ndanyliw/nanoquad/README.md

nanoquad
========

A low cost quadcopter development platform
