ndanyliw/nanoquad/hardware/Quadrocopter BOM.xlsx

Sheet: BOM
Parts for Quadrocopter
Part | Quantity | Cost | Supplier | Category | Description | URL | Link | Total Cost | Total Cost | $33.41
2.4Ghz Wireless nRF24L01+ Transceiver Module | 1 | $3.84 | ebay | Communication | 1X NRF24L01+ 2.4GHz Antenna Wireless Transceiver Module For Microcontroller EP98 | http://www.ebay.com/sch/?_kw=NRF24L01%2B&_clu=2&_fcid=229&_localstpos=&_sc=1&_sop=15&_stpos=&gbr=1 | link | $3.84
Female Headers | 11 | $0.04 | Sparkfun | Communication | 4x2 Pin Female Header | https://www.sparkfun.com/products/115 | link | $0.41
Male Header | 6 | $0.04 | Sparkfun | Communication | 3x2 Pin Male Header for ICSP | https://www.sparkfun.com/products/116 | link | $0.22
2.4Ghz Wireless nRF24L01+ Transceiver Module | 0 | $6.95 | mdfly | Communication | 2.4Ghz Wireless nRF24L01+ Transceiver Module | http://www.mdfly.com/index.php?main_page=product_info&products_id=81 | link | $0.00
2.4GHz Transceiver IC - nRF24L01+ | 0 | $3.50 | Sparkfun | Communication | 2.4GHz Transceiver IC - nRF24L01+ | https://www.sparkfun.com/products/690 | link | $0.00
7 x 16 Coreless DC Motor | 4 | $1.33 | ebay | Drive | 5pcs x Coreless Motor Aeromodelling Motor Helicopter Motor Size: 7x16 | http://www.ebay.com/itm/5pcs-x-Coreless-Motor-Aeromodelling-Motor-Helicopter-Motor-Size-7x16-/160888004987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 | link | $5.32
4 Quad Propellers | 1 | $1.85 | ebay | Drive | Walkera Mini Quadcopter Spare Part QR-Ladybird-Z-01 Main Blades Propellers Set | http://www.ebay.com/itm/Walkera-Mini-Quadcopter-Spare-Part-QR-Ladybird-Z-01-Main-Blades-Propellers-Set-/310559189326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 | link | $1.85
PMGD370XN | 0 | $0.13 | Mouser | Drive | MOSFET N-CH TRENCH DL 30V | http://www.mouser.com/ProductDetail/NXP-Semiconductors/PMGD370XN115/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 | link | $0.00
Diode | 4 | $0.04 | Mouser | Drive | BAS16-V-GS18 | http://www.mouser.com/ProductDetail/Vishay-Semiconductors/BAS16-V-GS18/ | link | $0.16
6x12 Coreless DC Motor | 0 | $2.05 | DHGate | Drive | Wholesale - 6*12 Mini Coreless Motor 7500RPM electrical motor for micro vibration motor rc heli part diy toys | http://www.dhgate.com/6-12-mini-coreless-motor-7500rpm-electrical/p-ff80808139bf03750139bf80a4972d47.html | link | $0.00
Motor + Propeller Pair | 0 | $6.84 | DHGate | Drive | Wholesale - Four-axis Aircraft Motor Coreless Motor 48000rpm Model Aircraft Motor DIY Toy Parts 5 pairs/lot | http://www.dhgate.com/four-axis-aircraft-motor-coreless-motor-48000rpm/p-ff8080813b22dc5c013b5fcff16c3354.html | link | $0.00
Propeller | 0 | $1.25 | Infinite Hobby | Drive | 3 X 2 plastic Push & Pull | http://www.infinity-hobby.com/main/product_info.php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 | link | $0.00
3.7 V LiPo Battery 240 mAh | 1 | $2.99 | completeheli.com | Power | Hyperion G3 1S 3.7v 240mAh 25C LiPo Battery | http://www.completeheli.com/hyperion-g3-1s-3-7v-240mah-25c-lipo-battery.htm | link | $2.99
TPS61201DRCT | 1 | $2.92 | Mouser | Power | 3.3V DC/DC Switching Regulators 0.3V In Vltg Boost | http://www.mouser.com/ProductDetail/Texas-Instruments/TPS61201DRCT/?qs=sGAEpiMZZMtY9G8Xaw%2fcnn4j7h5zvZsV | link | $2.92
SPDT Switch | 1 | $0.95 | Sparkfun | Power | SMD power switch | https://www.sparkfun.com/products/10860 | link | $0.95
MCP73831 | 1 | $0.60 | Mouser | Power | LiPo Battery Management Charge mgnt contr | http://www.mouser.com/ProductDetail/Microchip-Technology/MCP73831T-2ACI-OT/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 | link | $0.60
2.2 uH Inductor | 1 | $0.29 | Mouser | Power | Fixed Inductors INDCTR LW PROFL WND 1007 2.2uH 20% | http://www.mouser.com/ProductDetail/Taiyo-Yuden/BRHL2518T2R2M/ | link | $0.29
3.7 V LiPo Battery 250 mAh | 0 | $3.99 | AllBattery | Power | Tenergy 3.7V 250mAh 25C LIPO Rechargeable Battery (for MCPX helicopter) | http://www.all-battery.com/Tenergy3.7V250mAh25CLIPORechargeableBattery-30194.aspx | link | $0.00
ATMEGA 328P-AU | 1 | $3.05 | Mouser | Processing | AVR 8-bit uC | http://www.mouser.com/ProductDetail/Atmel/ATMEGA328P-AU/ | link | $3.05
PTS525SM10SMTR | 1 | $0.57 | Mouser | Processing | SMT Reset Switch | http://www.mouser.com/ProductDetail/CK-Components/PTS525SM10SMTR-LFS/ | link | $0.57
16 MHz Crystal | 1 | $0.39 | Mouser | Processing | 16 MHz Crystal, 18 pF, SMD | http://www.mouser.com/ProductDetail/CTS-Electronic-Components/ATS16BSM-1/ | link | $0.39
10 uF Capacitor | 2 | $0.16 | Mouser | Processing | 08056D106KAT2A | http://www.mouser.com/ProductDetail/AVX/08056D106KAT2A/ | link | $0.32
0.1 uF Capacitor | 4 | $0.06 | Mouser | Processing | VJ0805Y104MXXAC | http://www.mouser.com/ProductDetail/Vishay-Vitramon/VJ0805Y104MXXAC/ | link | $0.24
10k Resistor | 5 | $0.04 | Mouser | Processing | 652-CRT0805FZ1002ELF | http://www.mouser.com/ProductDetail/Bourns/CRT0805-FZ-1002ELF/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 | link | $0.20
470 Resistor | 2 | $0.09 | Mouser | Processing | ERA-6AED471V | http://www.mouser.com/ProductDetail/Panasonic-Electronic-Components/ERA-6AED471V/ | link | $0.18
18 pF Cap | 2 | $0.06 | Mouser | Processing | Multilayer Ceramic Capacitors MLCC - SMD/SMT 0805 18pF 10volts C0G 2% | http://www.mouser.com/ProductDetail/Vishay-Vitramon/VJ0805A180GXQCW1BC/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 | link | $0.12
1 nF Capacitor | 2 | $0.06 | Mouser | Processing | VJ0805A102KXAPW1BC | http://www.mouser.com/ProductDetail/Vishay-Vitramon/VJ0805A102KXAPW1BC/ | link | $0.12
1 uF Capacitor | 2 | $0.06 | Mouser | Processing | Multilayer Ceramic Capacitors MLCC - SMD/SMT 0805 1uF 10volts X7R 10% | http://www.mouser.com/ProductDetail/Vishay-Vitramon/VJ0805Y105KXQTW1BC/ | link | $0.12
4.7 uF Capacitor | 2 | $0.06 | Mouser | Processing | VJ0805V475MXQTW1BC | http://www.mouser.com/ProductDetail/Vishay-Vitramon/VJ0805V475MXQTW1BC/ | link | $0.12
Red LED | 1 | $0.10 | Mouser | Processing | 598-8210-107F | http://www.mouser.com/ProductDetail/Dialight/598-8210-107F/?qs=sGAEpiMZZMtEjy7lsqBi5TMaylv1X7iuXYL5BhasljI%3d | link | $0.10
Green LED | 1 | $0.10 | Mouser | Processing | 598-8270-107F | http://www.mouser.com/ProductDetail/Dialight/598-8270-107F/?qs=sGAEpiMZZMtEjy7lsqBi5TMaylv1X7iuX8bwcRPi1pw%3d | link | $0.10
220k Resistor | 1 | $0.09 | Mouser | Processing | ERA-6AED224V | http://www.mouser.com/ProductDetail/Panasonic-Electronic-Components/ERA-6AED224V/ | link | $0.09
2k Resistor | 1 | $0.09 | Mouser | Processing | ERA-6AED202V | http://www.mouser.com/ProductDetail/Panasonic-Electronic-Components/ERA-6AED202V/ | link | $0.09
2M Resistor | 1 | $0.05 | Mouser | Processing | CR0805-JW-205ELF | http://www.mouser.com/ProductDetail/Bourns/CR0805-JW-205ELF/ | link | $0.05
22 nF Capacitor | 0 | $0.09 | Mouser | Processing | VJ0805A222JXAAT | http://www.mouser.com/ProductDetail/Vishay-Vitramon/VJ0805A222JXAAT/ | link | $0.00
L3GD20 | 1 | $6.33 | Mouser | Sensing | Gyroscopes MEMS 3-Axis GRYO 16-Bit Data 1.8V | http://www.mouser.com/ProductDetail/STMicroelectronics/L3GD20/?qs=sGAEpiMZZMswmUeu4VmiECN28rly3Qbx | link | $6.33
MMA8652FCR1 | 1 | $1.10 | Mouser | Sensing | Board Mount Accelerometers 3-axis 2g/4g/8g 12 bit | http://www.mouser.com/ProductDetail/Freescale-Semiconductor/MMA8652FCR1/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 | link | $1.10
Accelerometer/Magnometer | 0 | $6.35 | Mouser | Sensing | Board Mount Accelerometers E-compass 3D accel & 3D magnetometer mod. | http://www.mouser.com/ProductDetail/STMicroelectronics/LSM303DLHC/ | link | $0.00
SI1902CDL-T1-GE3 | 2 | $0.28 | Mouser | Drive | MOSFET 20V 1A DUAL NCH | http://www.mouser.com/Search/ProductDetail.aspx | link | $0.56

Sheet: Total Cost
Date | Description | Cost | Total: | $36.02 | Balance: | $238.98
2013-02-23 | Freescale Accellerometer Sample order | $5.00
2013-02-19 | 5x Motors | $8.15
2013-02-19 | 2x NRF Radios | $7.73
2013-03-09 | R2 Boards ordered | $15.14
