ndanyliw/nanoquad/hardware/frame/QuadcopterV3.SLDASM

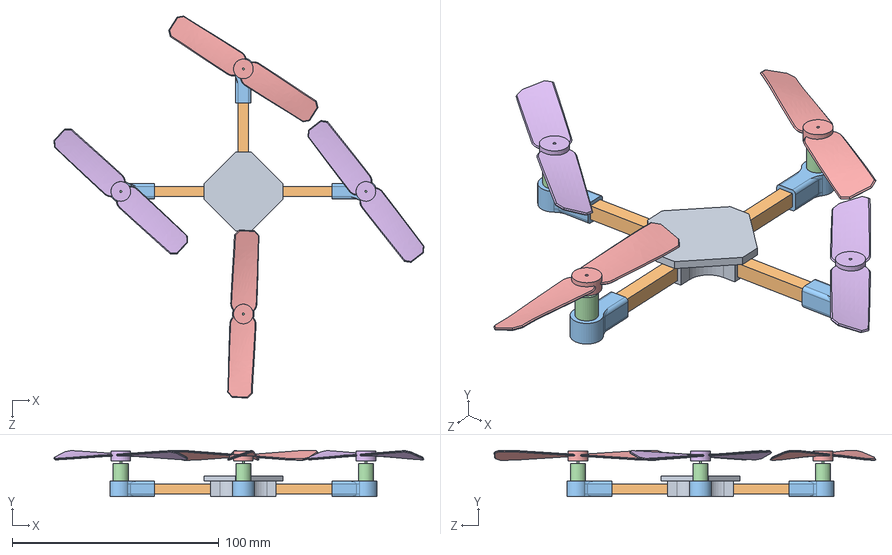
[picture p1: CAD file, 2014-05-21]
hardware/frame/QuadcopterV3.SLDASM
178.8 x 22.5 x 184.7 mm
Base
QuadcopterArm x 4
MotorHolder x 4
7x16Motor x 4
propellor(CCW) x 2
propellor(CW) x 2
