ndanyliw/nanoquad/hardware/frame/MainBoard.SLDPRT

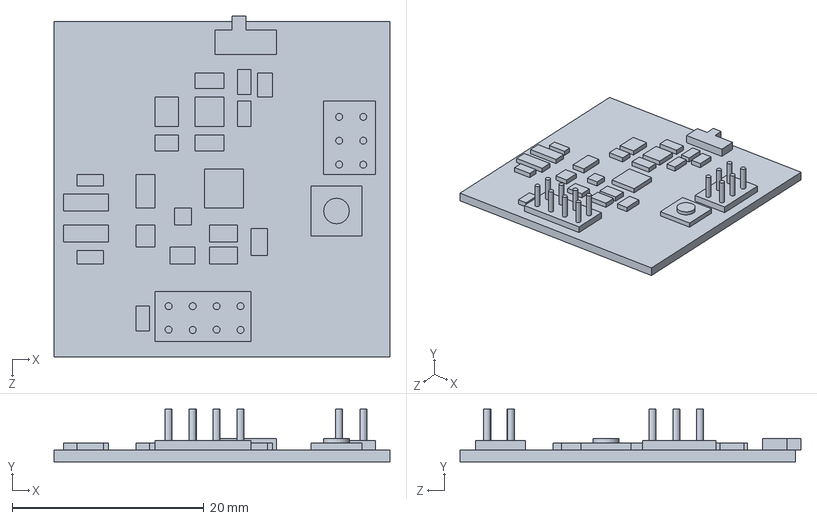
[picture p2: CAD file, 2014-05-21]
hardware/frame/MainBoard.SLDPRT
35.1 x 5.52 x 35.6 mm
