ndanyliw/nanoquad/hardware/frame/propellor(CCW).SLDPRT

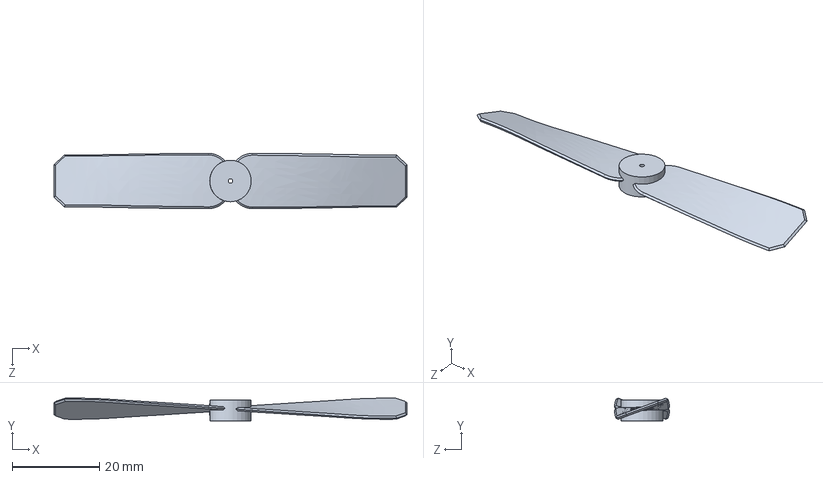
[picture p3: CAD file, 2014-05-21]
hardware/frame/propellor(CCW).SLDPRT
81.0 x 5.20 x 12.7 mm
