ndanyliw/nanoquad/hardware/frame/BaseSmallBracket.SLDPRT

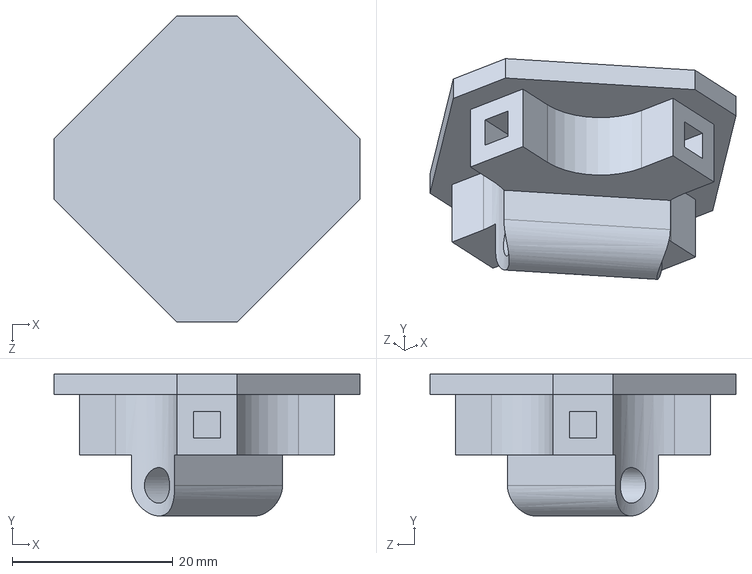
[picture p4: CAD file, 2014-05-21]
hardware/frame/BaseSmallBracket.SLDPRT
38.1 x 17.7 x 38.1 mm
