ndanyliw/nanoquad/hardware/frame/QuadcopterArm.SLDPRT

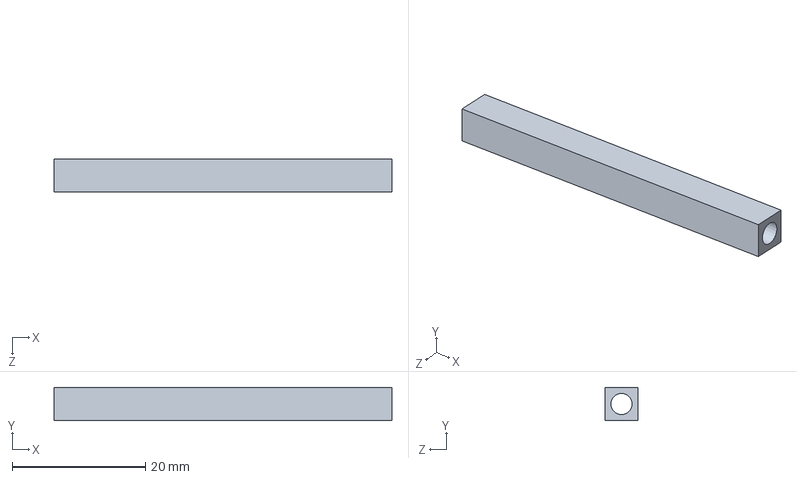
[picture p5: CAD file, 2014-05-21]
hardware/frame/QuadcopterArm.SLDPRT
50.8 x 4.98 x 4.98 mm
