ndanyliw/nanoquad/hardware/frame/propellor(CW).SLDPRT

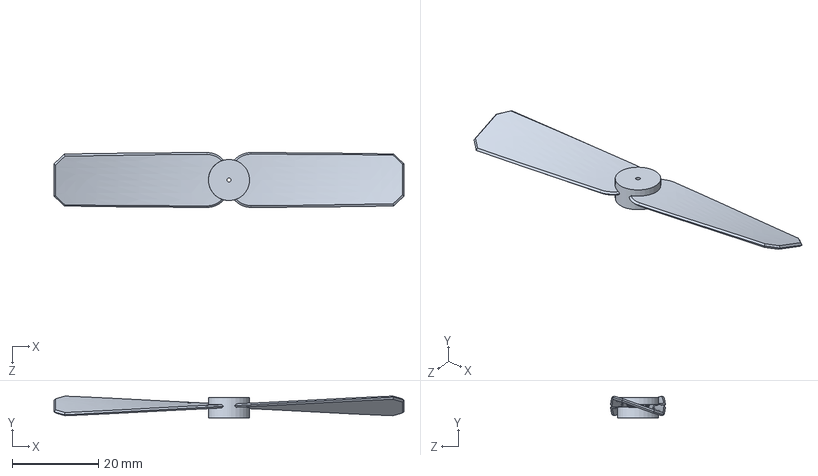
[picture p6: CAD file, 2014-05-21]
hardware/frame/propellor(CW).SLDPRT
81.0 x 5.06 x 12.7 mm
