ndanyliw/nanoquad/hardware/frame/BaseSmall.SLDPRT

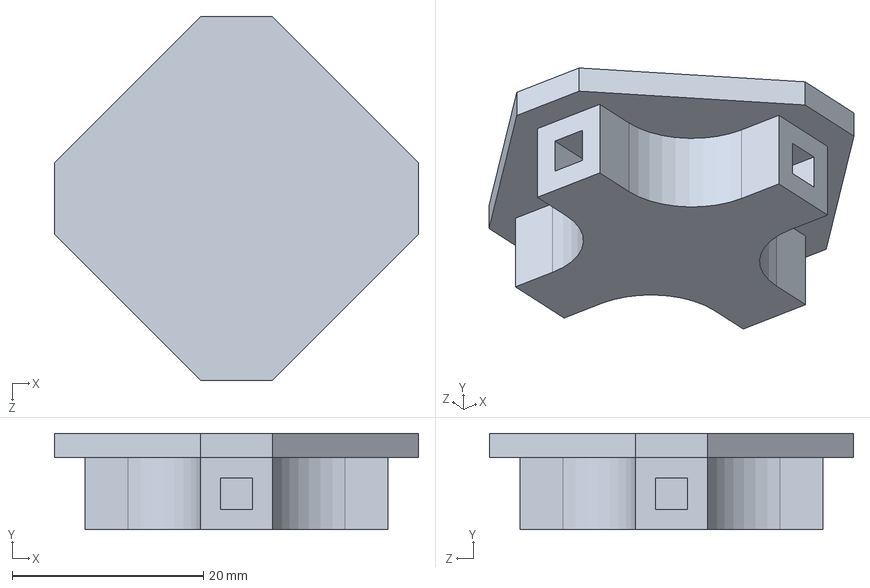
[picture p7: CAD file, 2014-05-21]
hardware/frame/BaseSmall.SLDPRT
38.1 x 10.1 x 38.1 mm
