ndanyliw/nanoquad/hardware/frame/MotorHolder.SLDPRT

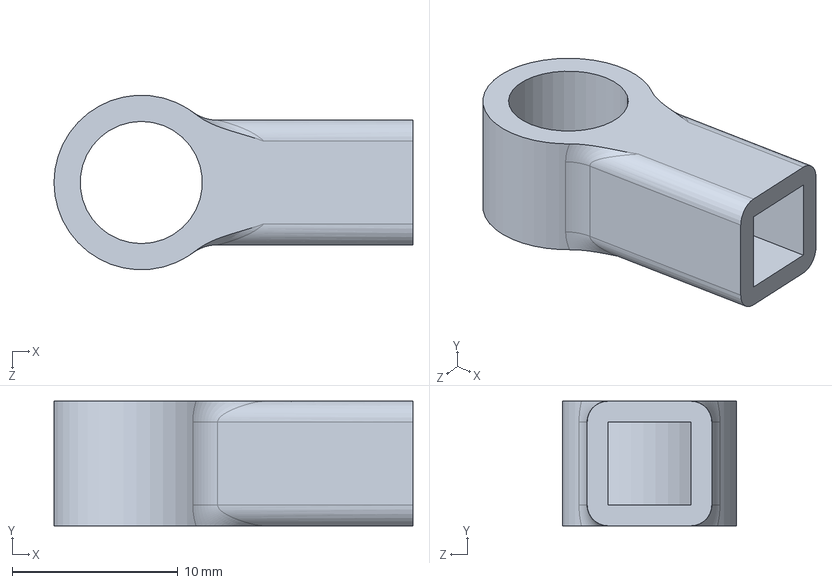
[picture p8: CAD file, 2014-05-21]
hardware/frame/MotorHolder.SLDPRT
21.6 x 7.52 x 10.5 mm
