ndanyliw/nanoquad/hardware/frame/MotorHolderSmall.SLDPRT

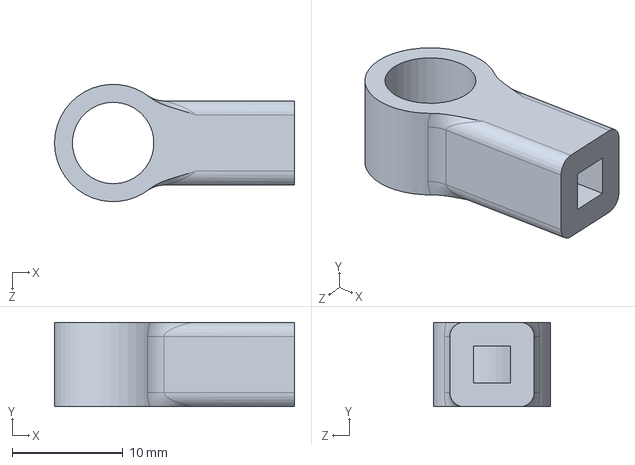
[picture p9: CAD file, 2014-05-21]
hardware/frame/MotorHolderSmall.SLDPRT
21.7 x 7.62 x 10.6 mm
