ndanyliw/nanoquad/hardware/flight_controller/R3/MainBoardR3.brd

## EAGLE design hardware/flight_controller/R3/MainBoardR3.brd (2014-05-21)

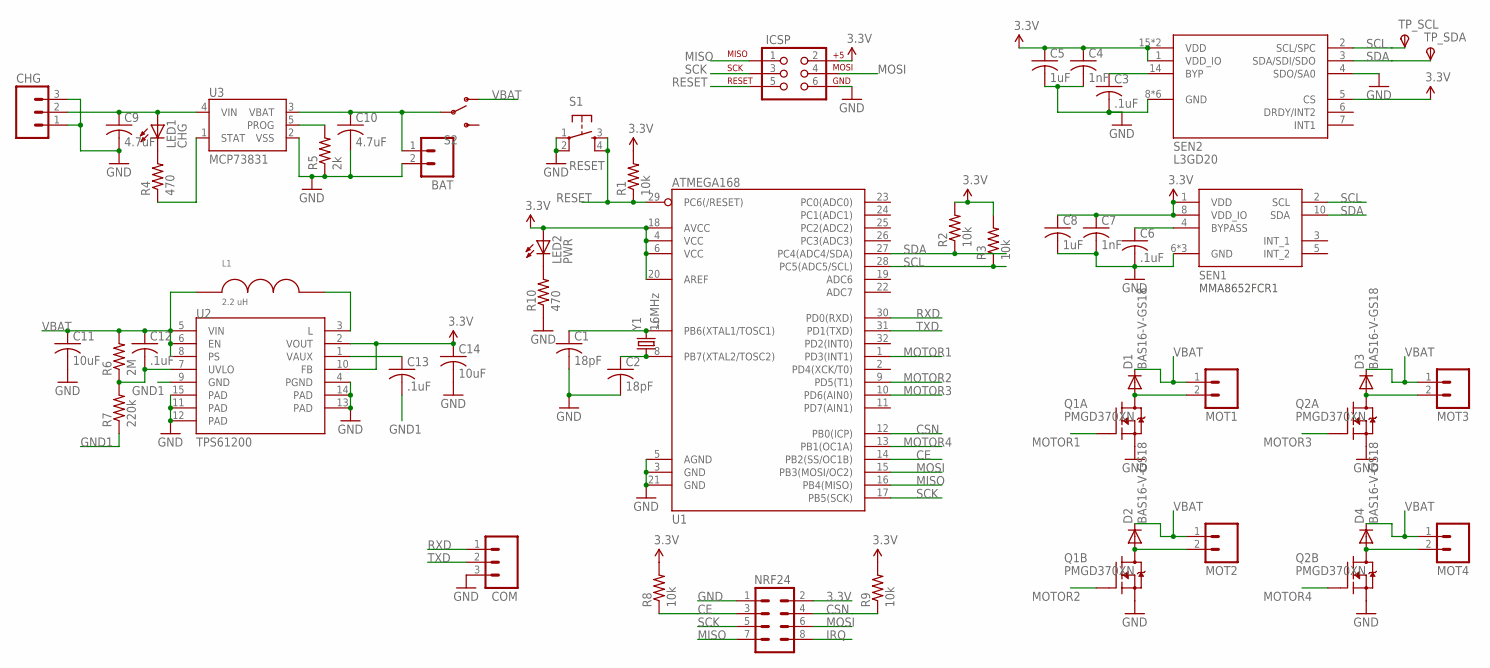
[picture p10: schematic MainBoardR3.sch]

Parts:
BAT: M02LOCK_LONGPADS; 1X02_LOCK_LONGPADS
C1, C2: 18pF; C0805
C3, C6, C12, C13: .1uF; C0805
C4, C7: 1nF; C0805
C5, C8: 1uF; C0805
C9, C10: 4.7uF; C0805
C11, C14: 10uF; C0805
CHG: M03LONGPADS; 1X03_LONGPADS
COM: M03LONGPADS; 1X03_LONGPADS
D1, D2, D3, D4: BAS16-V-GS18; SOT23
ICSP: AVR_SPI_PRG_62X3_LOCK; 2X3_LOCK
L1: 2.2 uH; 2518
LED1: CHG; LED-1206
LED2: PWR; LED-1206
MOT1, MOT2, MOT3, MOT4: M02LOCK_LONGPADS; 1X02_LOCK_LONGPADS
NRF24: M04X2; 2X4
Q1, Q2: PMGD370XN; SOT363_INFINEON
R1, R2, R3, R8, R9: 10k; 0805
R4, R10: 470; 0805
R5: 2k; 0805
R6: 2M; 0805
R7: 220k; 0805
S1: RESET; TACTILE_SWITCH_SMD
S2: SWITCH-SPST-SMD-A
SEN1: MMA8652FCR1; 10_PIN_DFN
SEN2: L3GD20; LGA-16
TP_SCL: TPSTP14SQ; TP14SQ
TP_SDA: TPSTP14SQ; TP14SQ
U1: ATMEGA168; TQFP32-08
U2: TPS61200; QFN-10_PAD
U3: MCP73831; SOT23-5
Y1: 16MHz; CRYSTAL-SMD-10.5X4.8-2PIN

Connections:
3.3V: C4.1, C5.1, C7.1, C8.1, C14.1, ICSP.2, LED2.A, NRF24.2, R1.2, R2.2, R3.2, R8.2, R9.2, SEN1.1 (VDD), SEN1.8 (VDD_IO), SEN2.1 (VDD_IO), SEN2.5 (CS), SEN2.15 (VDD), SEN2.16 (VDD), U1.4 (VCC), U1.6 (VCC), U1.18 (AVCC), U1.20 (AREF), U2.2 (VOUT), U2.10 (FB)
BAT+: BAT.1, C10.1, S2.2, U3.3 (VBAT)
CE: NRF24.3, R8.1, U1.14 (PB2(SS/OC1B))
CSN: NRF24.4, R9.1, U1.12 (PB0(ICP))
GND: BAT.2, C1.2, C2.2, C3.2, C4.2, C5.2, C6.2, C7.2, C8.2, C9.2, C10.2, C11.2, C14.2, CHG.1, CHG.3, COM.3, ICSP.6, NRF24.1, Q1.1 (S), Q1.4 (S), Q2.1 (S), Q2.4 (S), R5.1, R10.1, S1.1, S1.2, SEN1.6 (GND), SEN1.7 (GND), SEN1.9 (GND), SEN2.4 (SDO/SA0), SEN2.8 (GND), SEN2.9 (GND), SEN2.10 (GND), SEN2.11 (GND), SEN2.12 (GND), SEN2.13 (GND), U1.3 (GND), U1.5 (AGND), U1.21 (GND), U2.4 (PGND), U2.11 (PAD), U2.12 (PAD), U2.13 (PAD), U2.14 (PAD), U2.15 (PAD), U3.2 (VSS)
GND1: C13.2, R7.1, U2.9 (GND)
IRQ: NRF24.8
MISO: ICSP.1, NRF24.7, U1.16 (PB4(MISO))
MOSI: ICSP.4, NRF24.6, U1.15 (PB3(MOSI/OC2))
MOT1-: D1.1 (A), MOT1.2, Q1.6 (D)
MOT2-: D2.1 (A), MOT2.2, Q1.3 (D)
MOT3-: D3.1 (A), MOT3.2, Q2.6 (D)
MOT4-: D4.1 (A), MOT4.2, Q2.3 (D)
MOTOR1: Q1.2 (G), U1.1 (PD3(INT1))
MOTOR2: Q1.5 (G), U1.9 (PD5(T1))
MOTOR3: Q2.2 (G), U1.10 (PD6(AIN0))
MOTOR4: Q2.5 (G), U1.13 (PB1(OC1A))
unnamed: C3.1, SEN2.14 (BYP)
unnamed: C1.1, U1.7 (PB6(XTAL1/TOSC1)), Y1.P$2 (2)
unnamed: C2.1, U1.8 (PB7(XTAL2/TOSC2)), Y1.P$1 (1)
unnamed: LED1.C, R4.2
unnamed: C6.1, SEN1.4 (BYPASS)
unnamed: R4.1, U3.1 (STAT)
unnamed: R5.2, U3.5 (PROG)
unnamed: C13.1, U2.1 (VAUX)
unnamed: C12.2, R6.1, R7.2, U2.7 (UVLO)
unnamed: LED2.C, R10.2
unnamed: L1.P$2 (2), U2.3 (L)
RESET: ICSP.5, R1.1, S1.3, S1.4, U1.29 (PC6(/RESET))
RXD: COM.1, U1.30 (PD0(RXD))
SCK: ICSP.3, NRF24.5, U1.17 (PB5(SCK))
SCL: R3.1, SEN1.2 (SCL), SEN2.2 (SCL/SPC), TP_SCL.TP, U1.28 (PC5(ADC5/SCL))
SDA: R2.1, SEN1.10 (SDA), SEN2.3 (SDA/SDI/SDO), TP_SDA.TP, U1.27 (PC4(ADC4/SDA))
TXD: COM.2, U1.31 (PD1(TXD))
VBAT: C11.1, C12.1, D1.3 (C), D2.3 (C), D3.3 (C), D4.3 (C), L1.P$1 (1), MOT1.1, MOT2.1, MOT3.1, MOT4.1, R6.2, S2.1 (O), U2.5 (VIN), U2.6 (EN), U2.8 (PS)
VIN: C9.1, CHG.2, LED1.A, U3.4 (VIN)

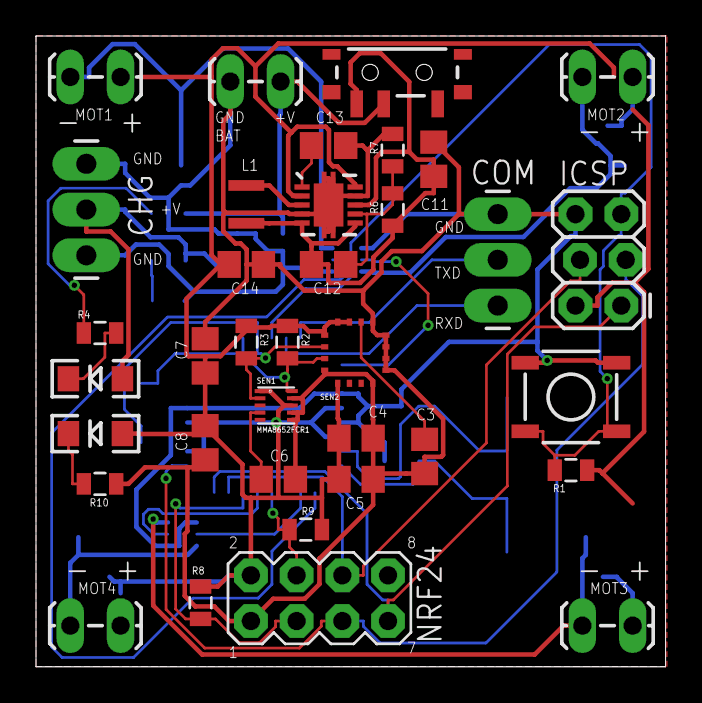
[picture p11: board MainBoardR3.brd from above]

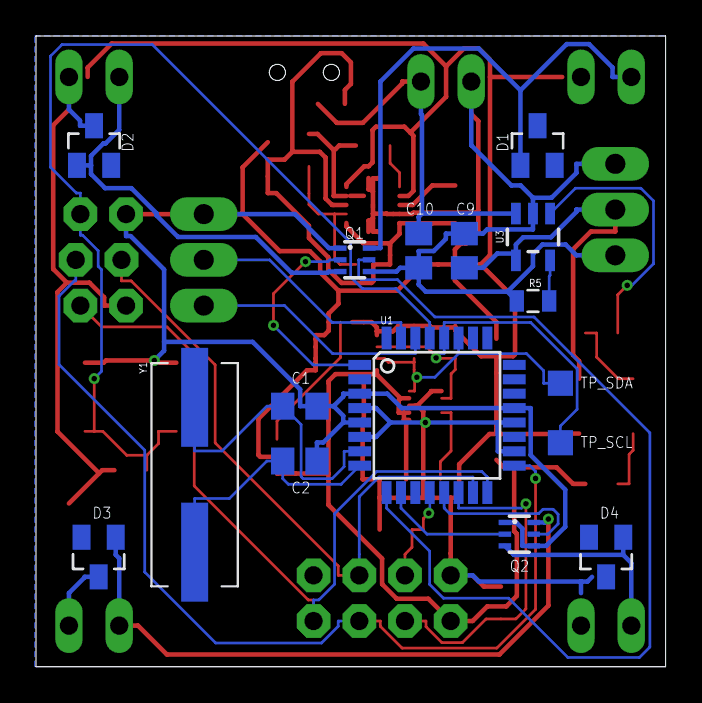
[picture p12: board MainBoardR3.brd from below]

Board: 2 copper layers, 35.0 x 35.0 mm, 52 parts (16 on the bottom side), 35 nets.
