ndanyliw/nanoquad/hardware/flight_controller/R5/MainBoardR5.brd

## EAGLE design hardware/flight_controller/R5/MainBoardR5.brd (2014-05-21)

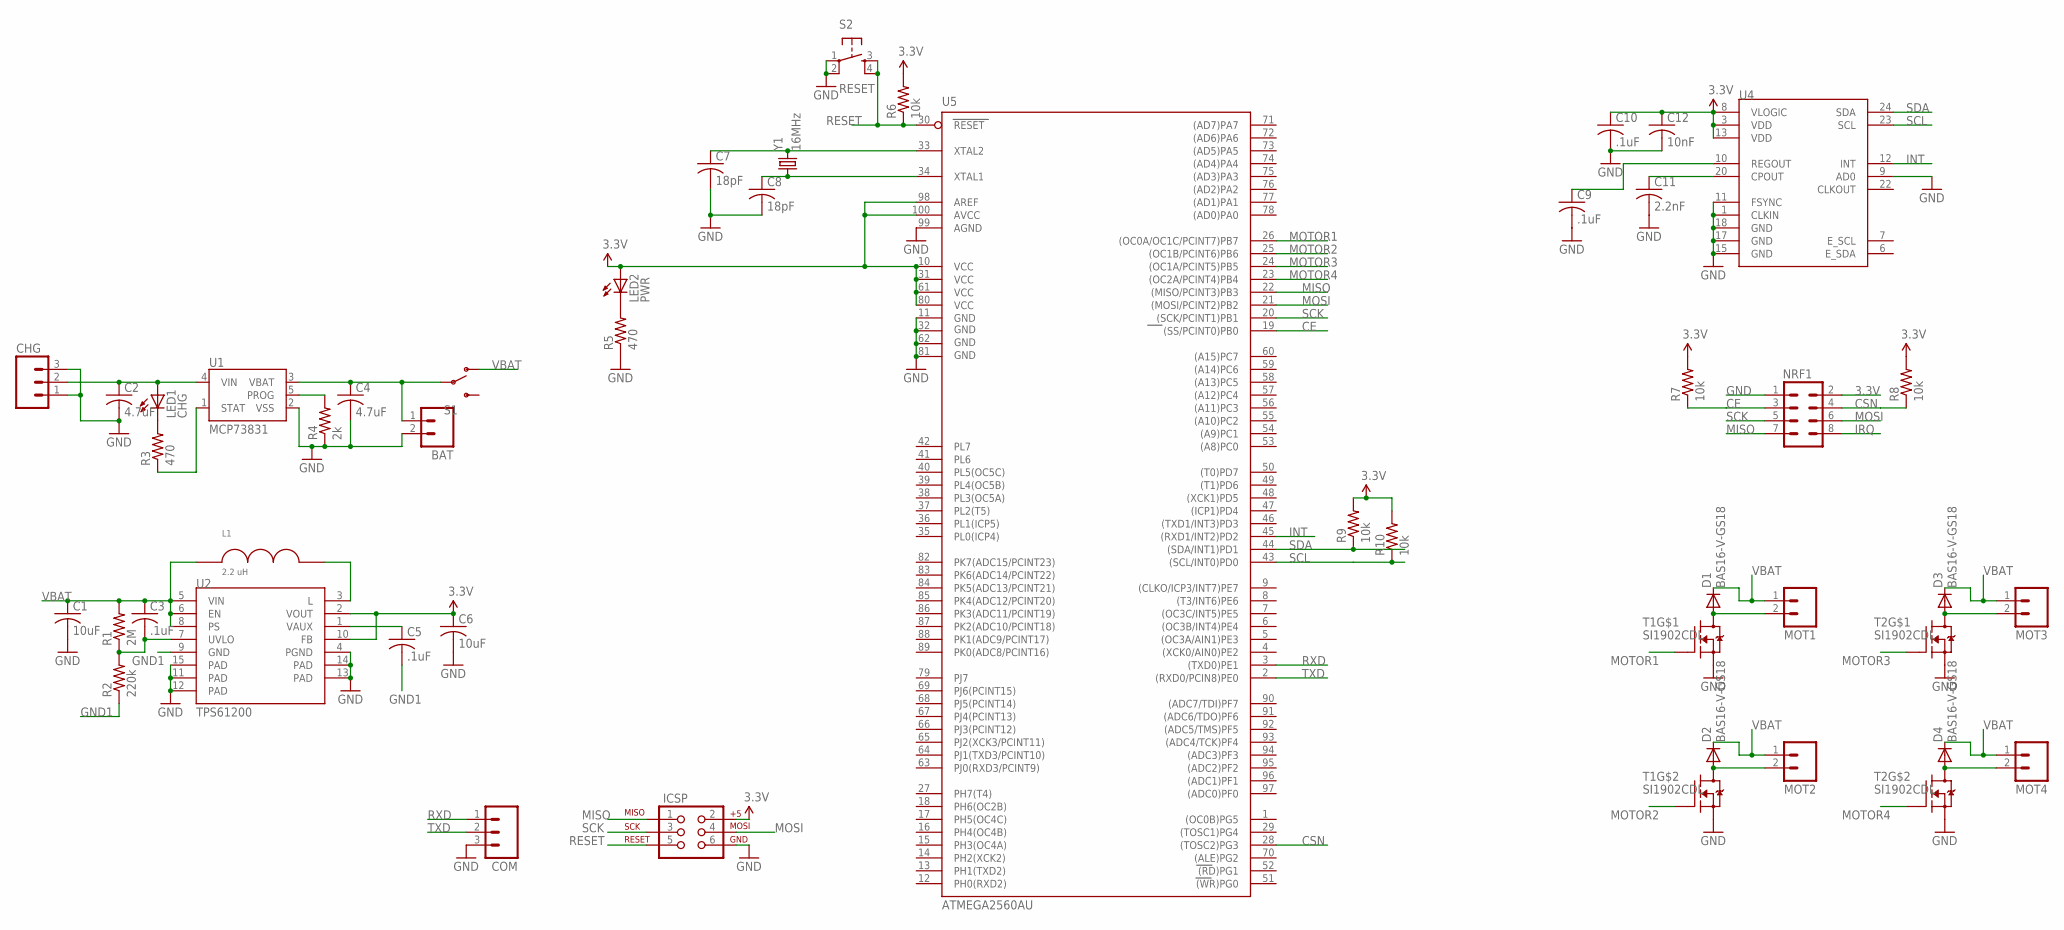
[picture p13: schematic MainBoardR5.sch]

Parts:
BAT: M02LOCK_LONGPADS; 1X02_LOCK_LONGPADS
C1, C6: 10uF; C0805
C2, C4: 4.7uF; C0805
C3, C5, C9, C10: .1uF; C0805
C7, C8: 18pF; C0805
C11: 2.2nF; C0805
C12: 10nF; C0805
CHG: M03LONGPADS; 1X03_LONGPADS
COM: M03LONGPADS; 1X03_LONGPADS
D1, D2, D3, D4: BAS16-V-GS18; SOT23
ICSP: AVR_SPI_PRG_62X3_LOCK; 2X3_LOCK
L1: 2.2 uH; 2518
LED1: CHG; LED-1206
LED2: PWR; LED-1206
MOT1, MOT2, MOT3, MOT4: M02LOCK_LONGPADS; 1X02_LOCK_LONGPADS
NRF1: M04X2; 2X4
R1: 2M; 0805
R2: 220k; 0805
R3, R5: 470; 0805
R4: 2k; 0805
R6, R7, R8, R9, R10: 10k; 0805
S1: SWITCH-SPST-SMD-A
S2: RESET; TACTILE_SWITCH_SMD
T1, T2: SI1902CDL; SOT363_INFINEON
U1: MCP73831; SOT23-5
U2: TPS61200; QFN-10_PAD
U4: MPU-9150QFN-24-NP; QFN-24-NP
U5: ATMEGA2560AU; TQFP100
Y1: 16MHz; CRYSTAL-SMD-5X3

Connections:
3.3V: C6.1, C10.1, C12.1, ICSP.2, LED2.A, NRF1.2, R6.2, R7.2, R8.2, R9.2, R10.2, U2.2 (VOUT), U2.10 (FB), U4.3 (VDD), U4.8 (VLOGIC), U4.13 (VDD), U5.10 (VCC), U5.31 (VCC1), U5.61 (VCC2), U5.80 (VCC3), U5.98 (AREF), U5.100 (AVCC)
BAT+: BAT.1, C4.1, S1.2, U1.3 (VBAT)
CE: NRF1.3, R7.1, U5.19 ((SS/PCINT0)PB0)
CSN: NRF1.4, R8.1, U5.28 ((TOSC2)PG3)
GND: BAT.2, C1.2, C2.2, C4.2, C6.2, C7.2, C8.2, C9.2, C10.2, C11.2, C12.2, CHG.1, CHG.3, COM.3, ICSP.6, NRF1.1, R4.1, R5.1, S2.1, S2.2, T1.1 (S), T1.4 (S), T2.1 (S), T2.4 (S), U1.2 (VSS), U2.4 (PGND), U2.11 (PAD), U2.12 (PAD), U2.13 (PAD), U2.14 (PAD), U2.15 (PAD), U4.1 (CLKIN), U4.9 (AD0), U4.11 (FSYNC), U4.15 (GND), U4.17 (GND), U4.18 (GND), U5.11 (GND), U5.32 (GND1), U5.62 (GND2), U5.81 (GND3), U5.99 (AGND)
GND1: C5.2, R2.1, U2.9 (GND)
INT: U4.12 (INT), U5.45 ((RXD1/INT2)PD2)
IRQ: NRF1.8
MISO: ICSP.1, NRF1.7, U5.22 ((MISO/PCINT3)PB3)
MOSI: ICSP.4, NRF1.6, U5.21 ((MOSI/PCINT2)PB2)
MOT1-: D1.1 (A), MOT1.2, T1.6 (D)
MOT2-: D2.1 (A), MOT2.2, T1.3 (D)
MOT3-: D3.1 (A), MOT3.2, T2.6 (D)
MOT4-: D4.1 (A), MOT4.2, T2.3 (D)
MOTOR1: T1.2 (G), U5.26 ((OC0A/OC1C/PCINT7)PB7)
MOTOR2: T1.5 (G), U5.25 ((OC1B/PCINT6)PB6)
MOTOR3: T2.2 (G), U5.24 ((OC1A/PCINT5)PB5)
MOTOR4: T2.5 (G), U5.23 ((OC2A/PCINT4)PB4)
unnamed: C7.1, U5.33 (XTAL2), Y1.3 (2)
unnamed: C8.1, U5.34 (XTAL1), Y1.1
unnamed: C11.1, U4.20 (CPOUT)
unnamed: LED1.C, R3.2
unnamed: C9.1, U4.10 (REGOUT)
unnamed: R3.1, U1.1 (STAT)
unnamed: R4.2, U1.5 (PROG)
unnamed: C5.1, U2.1 (VAUX)
unnamed: C3.2, R1.1, R2.2, U2.7 (UVLO)
unnamed: LED2.C, R5.2
unnamed: L1.P$2 (2), U2.3 (L)
RESET: ICSP.5, R6.1, S2.3, S2.4, U5.30 (RESET)
RXD: COM.1, U5.3 ((TXD0)PE1)
SCK: ICSP.3, NRF1.5, U5.20 ((SCK/PCINT1)PB1)
SCL: R10.1, U4.23 (SCL), U5.43 ((SCL/INT0)PD0)
SDA: R9.1, U4.24 (SDA), U5.44 ((SDA/INT1)PD1)
TXD: COM.2, U5.2 ((RXD0/PCIN8)PE0)
VBAT: C1.1, C3.1, D1.3 (C), D2.3 (C), D3.3 (C), D4.3 (C), L1.P$1 (1), MOT1.1, MOT2.1, MOT3.1, MOT4.1, R1.2, S1.1 (O), U2.5 (VIN), U2.6 (EN), U2.8 (PS)
VIN: C2.1, CHG.2, LED1.A, U1.4 (VIN)

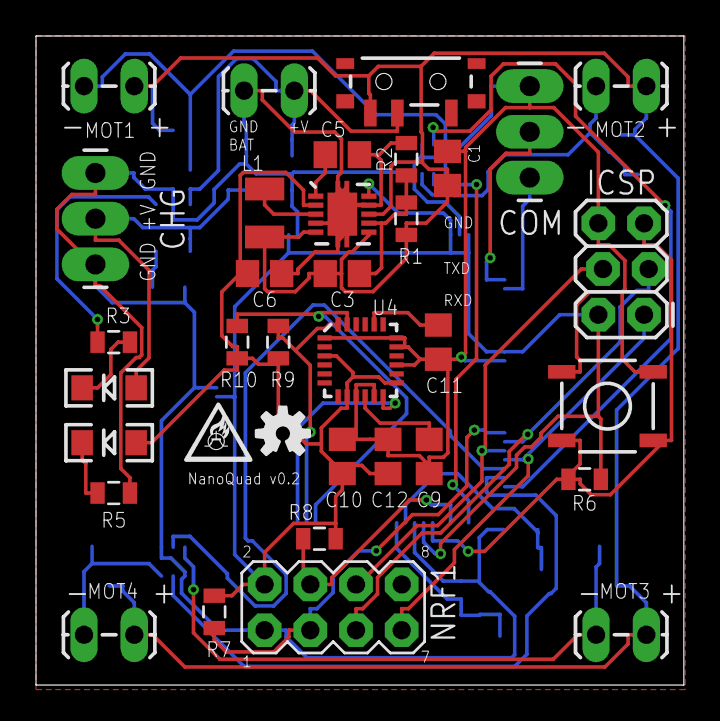
[picture p14: board MainBoardR5.brd from above]

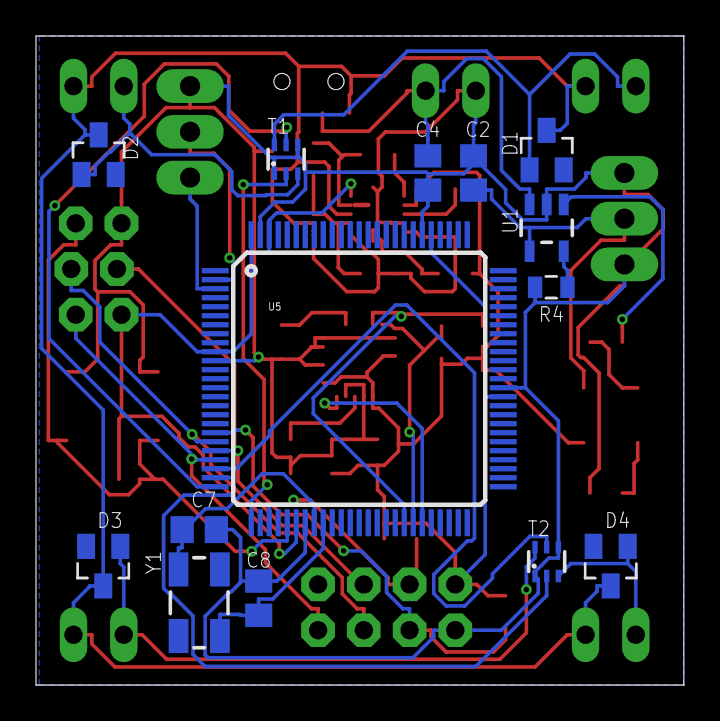
[picture p15: board MainBoardR5.brd from below]

Board: 2 copper layers, 36.0 x 36.1 mm, 49 parts (14 on the bottom side), 36 nets.

Other parts of the board:
U$1: BURNT_TRANSISTORS_XSM
U$2: OSHW-LOGO-S
