ndanyliw/nanoquad/(commit log)

2014-05-21 Added all current source files and hardware designs. Also added a hardware specific license file.
    [MainBoardR1.brd, MainBoardR1.sch, MainBoardR2.brd, MainBoardR2.sch, MainBoardR3.brd, MainBoardR3.sch, MainBoardR4.brd, MainBoardR4.sch]
2014-05-21 Added CAD files for frame
    [BaseSmall.SLDPRT, BaseSmallBracket.SLDPRT, MainBoard.SLDPRT, MotorHolder.SLDPRT, MotorHolderSmall.SLDPRT, QuadcopterArm.SLDPRT, QuadcopterV3.SLDASM, propellor(CCW).SLDPRT]
2014-07-15 Added BOM for Quadcopter parts
    [Quadrocopter BOM.xlsx]
